norioike/rino-Original-Robot/circuit_board/BOM_20200608.xlsx

Sheet: BOM
 | Total assembly board | 3 | pcs
# | Parts | QTY/module | Toal QTY | Manufacturer Part number | Value | Description | Package (inch) | SMD/THD | Accept to replace | Order assembling | Purchase site | Purchase link 1 | Purchase Link 2 | Note
1 | C1,C2 | 2 | 6 | CL10C300JB8NNNC | CAP CER 30PF 50V C0G/NP0 0603 | Capacitor | C0603 | SMD | YES | YES | LCSC | https://lcsc.com/product-detail/Multilayer-Ceramic-Capacitors-MLCC-SMD-SMT_SAMSUNG_CL10C300JB8NNNC_30pF-300-5-50V_C22397.html | https://www.digikey.jp/product-detail/ja/samsung-electro-mechanics/CL10C300JB8NNNC/1276-1021-1-ND/3889107
2 | C3,C7 | 2 | 6 | CL10A105KP8NNNC | CAP CER 1UF 10V X5R 0603 | Capacitor | C0603 | SMD | YES | YES | LCSC | https://lcsc.com/product-detail/Multilayer-Ceramic-Capacitors-MLCC-SMD-SMT_SAMSUNG_CL10A105KP8NNNC_1uF-105-10-10V_C26413.html | https://www.digikey.jp/product-detail/ja/samsung-electro-mechanics/CL10A105KP8NNNC/1276-1182-1-ND/3889268
3 | C4,C5,C9,C10,C12,C13,C15,C16,C17 | 9 | 27 | CC0603ZRY5V8BB104 | CAP CER 0.1UF 25V Y5V 0603 | Capacitor | C0603 | SMD | YES | YES | LCSC | https://lcsc.com/product-detail/Multilayer-Ceramic-Capacitors-MLCC-SMD-SMT_YAGEO-CC0603ZRY5V8BB104_C389102.html | https://www.digikey.jp/product-detail/ja/yageo/CC0603ZRY5V8BB104/311-1087-1-ND/302997
4 | C6,C8 | 2 | 6 | CC0603JRNPO9BN300 | CAP CER 22PF 50V C0G/NPO 0603 | Capacitor | C0603 | SMD | YES | YES | LCSC | https://lcsc.com/product-detail/Multilayer-Ceramic-Capacitors-MLCC-SMD-SMT_22pF-220-5-50V_C105620.html | https://www.digikey.jp/product-detail/ja/yageo/CC0603JRNPO9BN220/311-1062-1-ND/302972
5 | C11 | 1 | 3 | CL10A475KP8NNNC | CAP CER 4.7UF 10V X5R 0603 | Capacitor | C0603 | SMD | YES | YES | LCSC | https://lcsc.com/product-detail/Multilayer-Ceramic-Capacitors-MLCC-SMD-SMT_SAMSUNG_CL10A475KP8NNNC_4-7uF-475-10-10V_C1705.htmll | https://www.digikey.jp/product-detail/ja/samsung-electro-mechanics/CL10A475KP8NNNC/1276-1044-1-ND/3889130
6 | C14 | 1 | 3 | GRM21BR61A226ME51L | CAP CER 22UF 10V X5R 0805 | Capacitor | C0805 | SMD | YES | YES | LCSC | https://lcsc.com/product-detail/Multilayer-Ceramic-Capacitors-MLCC-SMD-SMT_muRata_GRM21BR61A226ME51L_22uF-226-20-10V_C77074.html | https://www.digikey.jp/product-detail/ja/murata-electronics/GRM21BR61A226ME51L/490-10511-1-ND/5026441
7 | CN1 | 1 | 3 | B5B-PH-K-S(LF)(SN) | CONN HEADER VERT 5POS 2MM | Connector |  | THD | YES | YES | LCSC | https://lcsc.com/product-detail/Wire-To-Board-Wire-To-Wire-Connector_JST-Sales-America_B5B-PH-K-S-LF-SN_JST-Sales-America-B5B-PH-K-S-LF-SN_C157993.html | https://www.digikey.jp/products/ja?keywords=B5B-PH-K-S(LF)(SN)
8 | CN2,CN3 | 2 | 6 | S3B-PH-SM4-TB(LF)(SN) | CONN HEADER SMD R/A 3POS 2MM | Connector |  | SMD | YES | YES | LCSC | https://lcsc.com/product-detail/Wire-To-Board-Wire-To-Wire-Connector_JST-Sales-America_S3B-PH-SM4-TB-LF-SN_JST-Sales-America-S3B-PH-SM4-TB-LF-SN_C265101.html | https://www.digikey.jp/product-detail/ja/jst-sales-america-inc/S3B-PH-SM4-TB-LF-SN/455-1750-1-ND/926847
9 | D1,D2 | 2 | 6 | MBR0520LT3G | DIODE SCHOTTKY 20V 500MA SOD123 | Diode | SOD-123 | SMD | YES | YES | LCSC | https://lcsc.com/product-detail/New-Quadratic-Unclassified-Data_Shikues-MBR0520_C475717.html | https://www.digikey.jp/product-detail/ja/on-semiconductor/MBR0520LT3G/MBR0520LT3GOSCT-ND/2705022
10 | EN,IO0 | 2 | 6 | KMR621NG LFS | SWITCH TACTILE SPST-NO 50MA 32V | tacktile switch |  | SMD | YES | YES | digikey | https://www.digikey.jp/product-detail/ja/c-k/KMR621NG-LFS/CKN10684CT-ND/6035356
11 | J1 | 1 | 3 | MC-318 | USB - Type C Female 24 SMD USB Connectors RoHS | USB type C |  | SMD | YES | YES | LCSC | https://www.digikey.jp/product-detail/ja/w%C3%BCrth-elektronik/632722110112/732-13724-1-ND/10056482 | https://lcsc.com/product-detail/USB-Connectors_SOFNG-MC-318_C183608.html
12 | J2 | 1 | 3 | M20-8890345 | CONN HEADER SMD R/A 3POS 2.54MM | pin header |  | SMD | YES | YES | digikey | https://www.digikey.jp/product-detail/ja/harwin-inc/M20-8890345/952-3232-ND/6565716
13 | LED1 | 1 | 3 | NCD0603G1 | Green 515~530nm 0603 Light Emitting Diodes (LED) RoHS | chip led | LED0603 | SMD | YES | YES | LCSC | https://lcsc.com/product-detail/Light-Emitting-Diodes-LED_Red-LED-SMDLED-80-100mcd_C84263.html
14 | LED2 | 1 | 3 | NCD0603R1 | Red 615~630nm 0603 Light Emitting Diodes (LED) RoHS | chip led | LED0603 | SMD | YES | YES | LCSC | https://lcsc.com/product-detail/Light-Emitting-Diodes-LED_Emerald-SMDLED-330-400mcd_C84267.html
15 | LED3 | 1 | 3 | NCD0603B1 | Blue 463~475nm 0603 Light Emitting Diodes (LED) RoHS | chip led | LED0603 | SMD | YES | YES | LCSC | https://lcsc.com/product-detail/Light-Emitting-Diodes-LED_Blue-light-SMDLED-80-100mcdatIF-10mA_C84266.html
16 | Q1 | 1 | 3 | BSS138 | N Channel 50V 220mA 1.6V @ 1mA 3.5Ω @ 220mA,10V 225mW SOT-23 MOSFET RoHS | Nch FET | SOT23 | SMD | YES | YES | LCSC | https://lcsc.com/product-detail/MOSFET_Slkor-SLKORMICRO-Elec-BSS138_C426569.html
17 | R1 | 1 | 3 | 0603WAJ0121T5E | 120 ±5% 1/10W ±100ppm/°C 0603 Chip Resistor - Surface Mount RoHS | Resistor | R0603 | SMD | YES | YES | LCSC | https://lcsc.com/product-detail/Chip-Resistor-Surface-Mount_UNI-ROYAL-Uniroyal-Elec-0603WAJ0121T5E_C25205.html
18 | R2,R5,R7 | 3 | 9 | RS-03K102JT | 1K ±5% 1/10W ±100ppm/°C 0603 Chip Resistor - Surface Mount RoHS | Resistor | R0603 | SMD | YES | YES | LCSC | https://lcsc.com/product-detail/Chip-Resistor-Surface-Mount_FH-Guangdong-Fenghua-Advanced-Tech-RS-03K102JT_C73797.html
19 | R3,R4,R6,R8,R9,R10,R13 | 7 | 21 | LE03WAJ0103T5E | 10K ±5% 1/10W 0603 LED Strip Resistors RoHS | Resistor | R0603 | SMD | YES | YES | LCSC | https://lcsc.com/product-detail/LED-Strip-Resistors_UNI-ROYAL-Uniroyal-Elec-LE03WAJ0103T5E_C81087.html
20 | R11,R12 | 2 | 6 | WR06X472JTL | 4.7K ±5% 1/10W ±100ppm/°C 0603 Chip Resistor - Surface Mount RoHS | Resistor | R0603 | SMD | YES | YES | LCSC | https://lcsc.com/product-detail/Chip-Resistor-Surface-Mount_Walsin-Tech-Corp-WR06X472JTL_C163915.html
21 | T1,T2 | 2 | 6 | SS8050G-Y1 | NPN 1.5A 25V 300mW SOT-23 Transistors (NPN/PNP) RoHS | Transistor | SOT23 | SMD | YES | YES | LCSC | https://lcsc.com/product-detail/New-Arrivals_Galaxy-SS8050G-Y1_C380930.html
22 | Y1 | 1 | 3 | X201616MOD4SI | 16MHz ±20ppm 12pF SMD-2016_4P SMD Crystal Resonators RoHS | crystal | SMD-2016_4P | SMD | YES | YES | LCSC | https://lcsc.com/product-detail/SMD-Crystal-Resonators_Yangxing-Tech-X201616MOD4SI_C108155.html
23 | U1 | 1 | 3 | MCP3425A0T-E/CH | 16 15 1 Differential SOT-23-6 Analog To Digital Converters (ADCs) RoHS | ADC | SOT-23-6 | SMD | NO | YES | LCSC | https://lcsc.com/product-detail/Analog-To-Digital-Converters-ADCs_MICROCHIP_MCP3425A0T-E-CH_MCP3425A0T-E-CH_C66823.html
24 | U2 | 1 | 3 | TJA1050T/CM,118 | Transceiver CAN 1/1 SOIC-8_150mil CAN ICs RoHS | TJA1050 | SOIC-8_150mil | SMD | NO | YES | LCSC | https://lcsc.com/product-detail/CAN-ICs_NXP-Semicon_TJA1050T-CM-118_NXP-Semicon-TJA1050T-CM-118_C6952.html
25 | U3 | 1 | 3 | MIC5504-3.3YM5-TR | Fixed 5.5V 3.3V 300mA SOT-23-5 Low Dropout Regulators(LDO) RoHS | LDO | SOT-23-5 | SMD | NO | YES | LCSC | https://lcsc.com/product-detail/_MICROCHIP_MIC5504-3-3YM5-TR_MIC5504-3-3YM5-TR_C88419.html
26 | U4 | 1 | 3 | MCP2515T-I/ST | Controller CAN TSSOP-20 CAN ICs RoHS | CAN Controller | TSSOP-20 | SMD | NO | YES | LCSC | https://lcsc.com/product-detail/CAN-ICs_Microchip-Tech_MCP2515T-I-ST_Microchip-Tech-MCP2515T-I-ST_C185941.html
27 | U5 | 1 | 3 | FT231XS-R | SSOP-20 USB ICs RoHS | USB IC | SSOP-20 | SMD | NO | YES | LCSC | https://lcsc.com/product-detail/USB-ICs_FTDI-Future-Designs_FT231XS-R_FTDI-Future-Designs-FT231XS-R_C132160.html
28 | U6 | 1 | 3 | ESP32-WROOM-32D(16MB) | Module WIFI Modules RoHS | MCU |  | SMD | NO | YES | LCSC | https://lcsc.com/product-detail/WIFI-Modules_Espressif-Systems-ESP32-WROOM-32D-16MB_C529578.html |  | Need TELEC MARK
29 | U7,U8,U9,U10,U11,U12,U13,U14,U15,U16, | 10 | 30 | WS2812B-2020 | full clolor LED with IC | full color LED | 2022 Package | SMD | NO | YES | aliexpress | https://ja.aliexpress.com/item/32876864437.html | http://www.world-semi.com/solution/list-4-1.html
30 | U17,U18,U19,U20,U21,U22,U23,U24,U25,U26, | 10 | 30 | WS2812B-2020 | full clolor LED with IC | full color LED | 2022 Package | SMD | NO | YES | aliexpress | https://ja.aliexpress.com/item/32876864437.html
31 | U27,U28,U29,U30,U31,U32,U33,U34,U35,U36, | 10 | 30 | WS2812B-2020 | full clolor LED with IC | full color LED | 2022 Package | SMD | NO | YES | aliexpress | https://ja.aliexpress.com/item/32876864437.html
32 | U37,U38,U39,U40,U41,U42,U43,U44,U45,U46, | 10 | 30 | WS2812B-2020 | full clolor LED with IC | full color LED | 2022 Package | SMD | NO | YES | aliexpress | https://ja.aliexpress.com/item/32876864437.html
33 | U47,U48,U49,U50,U51,U52,U53,U54,U55,U56, | 10 | 30 | WS2812B-2020 | full clolor LED with IC | full color LED | 2022 Package | SMD | NO | YES | aliexpress | https://ja.aliexpress.com/item/32876864437.html
34 | U57,U58,U59,U60,U61,U62,U63,U64,U65,U66, | 10 | 30 | WS2812B-2020 | full clolor LED with IC | full color LED | 2022 Package | SMD | NO | YES | aliexpress | https://ja.aliexpress.com/item/32876864437.html
35 | U67,U68,U69,U70,U71,U72,U73,U74,U75,U76, | 10 | 30 | WS2812B-2020 | full clolor LED with IC | full color LED | 2022 Package | SMD | NO | YES | aliexpress | https://ja.aliexpress.com/item/32876864437.html
36 | U77,U78,U79,U80,U81,U82,U83,U84,U85,U86, | 10 | 30 | WS2812B-2020 | full clolor LED with IC | full color LED | 2022 Package | SMD | NO | YES | aliexpress | https://ja.aliexpress.com/item/32876864437.html
37 | U87,U88,U89,U90,U91,U92,U93,U94,U95,U96, | 10 | 30 | WS2812B-2020 | full clolor LED with IC | full color LED | 2022 Package | SMD | NO | YES | aliexpress | https://ja.aliexpress.com/item/32876864437.html
38 | U97,U98,U99,U100,U101,U102,U103,U104,U105,U106, | 10 | 30 | WS2812B-2020 | full clolor LED with IC | full color LED | 2022 Package | SMD | NO | YES | aliexpress | https://ja.aliexpress.com/item/32876864437.html
39 | U107,U108,U109,U110,U111,U112,U113,U114,U115,U116, | 10 | 30 | WS2812B-2020 | full clolor LED with IC | full color LED | 2022 Package | SMD | NO | YES | aliexpress | https://ja.aliexpress.com/item/32876864437.html
40 | U117,U118,U119,U120,U121,U122,U123,U124,U125,U126, | 10 | 30 | WS2812B-2020 | full clolor LED with IC | full color LED | 2022 Package | SMD | NO | YES | aliexpress | https://ja.aliexpress.com/item/32876864437.html
41 | U127,U128,U129,U130,U131,U132,U133,U134,U135,U136, | 10 | 30 | WS2812B-2020 | full clolor LED with IC | full color LED | 2022 Package | SMD | NO | YES | aliexpress | https://ja.aliexpress.com/item/32876864437.html
42 | U137,U138,U139,U140,U141,U142,U143,U144,U145,U146, | 10 | 30 | WS2812B-2020 | full clolor LED with IC | full color LED | 2022 Package | SMD | NO | YES | aliexpress | https://ja.aliexpress.com/item/32876864437.html
43 | U147,U148,U149,U150,U151,U152,U153,U154,U155,U156, | 10 | 30 | WS2812B-2020 | full clolor LED with IC | full color LED | 2022 Package | SMD | NO | YES | aliexpress | https://ja.aliexpress.com/item/32876864437.html
44 | U157,U158,U159,U160,U161,U162,U163,U164,U165,U166, | 10 | 30 | WS2812B-2020 | full clolor LED with IC | full color LED | 2022 Package | SMD | NO | YES | aliexpress | https://ja.aliexpress.com/item/32876864437.html
45 | U167,U168,U169,U170,U171,U172,U173,U174,U175,U176, | 10 | 30 | WS2812B-2020 | full clolor LED with IC | full color LED | 2022 Package | SMD | NO | YES | aliexpress | https://ja.aliexpress.com/item/32876864437.html
46 | U177,U178,U179,U180,U181,U182,U183,U184,U185,U186, | 10 | 30 | WS2812B-2020 | full clolor LED with IC | full color LED | 2022 Package | SMD | NO | YES | aliexpress | https://ja.aliexpress.com/item/32876864437.html
47 | U187,U188,U189,U190,U191,U192,U193,U194,U195,U196, | 10 | 30 | WS2812B-2020 | full clolor LED with IC | full color LED | 2022 Package | SMD | NO | YES | aliexpress | https://ja.aliexpress.com/item/32876864437.html
48 | U197,U198,U199,U200,U201,U202,U203,U204,U205,U206, | 10 | 30 | WS2812B-2020 | full clolor LED with IC | full color LED | 2022 Package | SMD | NO | YES | aliexpress | https://ja.aliexpress.com/item/32876864437.html
49 | U207,U208,U209,U210,U211,U212,U213,U214,U215,U216, | 10 | 30 | WS2812B-2020 | full clolor LED with IC | full color LED | 2022 Package | SMD | NO | YES | aliexpress | https://ja.aliexpress.com/item/32876864437.html
50 | U217,U218,U219,U220,U221,U222,U223,U224,U225,U226, | 10 | 30 | WS2812B-2020 | full clolor LED with IC | full color LED | 2022 Package | SMD | NO | YES | aliexpress | https://ja.aliexpress.com/item/32876864437.html
51 | U227,U228,U229,U230,U231,U232,U233,U234,U235,U236, | 10 | 30 | WS2812B-2020 | full clolor LED with IC | full color LED | 2022 Package | SMD | NO | YES | aliexpress | https://ja.aliexpress.com/item/32876864437.html
52 | U237,U238,U239,U240,U241,U242,U243,U244,U245,U246, | 10 | 30 | WS2812B-2020 | full clolor LED with IC | full color LED | 2022 Package | SMD | NO | YES | aliexpress | https://ja.aliexpress.com/item/32876864437.html
53 | U247,U248,U249,U250,U251,U252,U253,U254,U255,U256, | 10 | 30 | WS2812B-2020 | full clolor LED with IC | full color LED | 2022 Package | SMD | NO | YES | aliexpress | https://ja.aliexpress.com/item/32876864437.html
54 | U257,U258,U259,U260,U261,U262,U263,U264,U265,U266, | 10 | 30 | WS2812B-2020 | full clolor LED with IC | full color LED | 2022 Package | SMD | NO | YES | aliexpress | https://ja.aliexpress.com/item/32876864437.html
55 | U267,U268,U269,U270,U271,U272,U273,U274,U275,U276, | 10 | 30 | WS2812B-2020 | full clolor LED with IC | full color LED | 2022 Package | SMD | NO | YES | aliexpress | https://ja.aliexpress.com/item/32876864437.html
56 | U277,U278,U279,U280,U281,U282,U283,U284,U285,U286 | 10 | 30 | WS2812B-2020 | full clolor LED with IC | full color LED | 2022 Package | SMD | NO | YES | aliexpress | https://ja.aliexpress.com/item/32876864437.html

Sheet: PCB Spec
PCB specification |  | Shipping address
Layer | 2 | postal code | 259-1132
board Dimensions | 134 x 126 mm | address | 2-19-39,Sakuradai,Isehara city,Kanagawa,Japan
PCB Qty | 7
Surface Finish | HASL free
PCB Color | Matt black
Copper Weight | 1oz
Text Color | White
Defferent Design | 2
PCB thickness | 1.6mm

Sheet: シート1
type C usb connector | https://lcsc.com/product-detail/USB-Connectors_SOFNG-MC-318_C183608.html
クロック | https://lcsc.com/product-detail/SMD-Crystal-Resonators_Yangxing-Tech-X201616MOD4SI_C108155.html
