norioike/rino-Original-Robot/circuit_board/mainBoard_schematic_1page.pdf

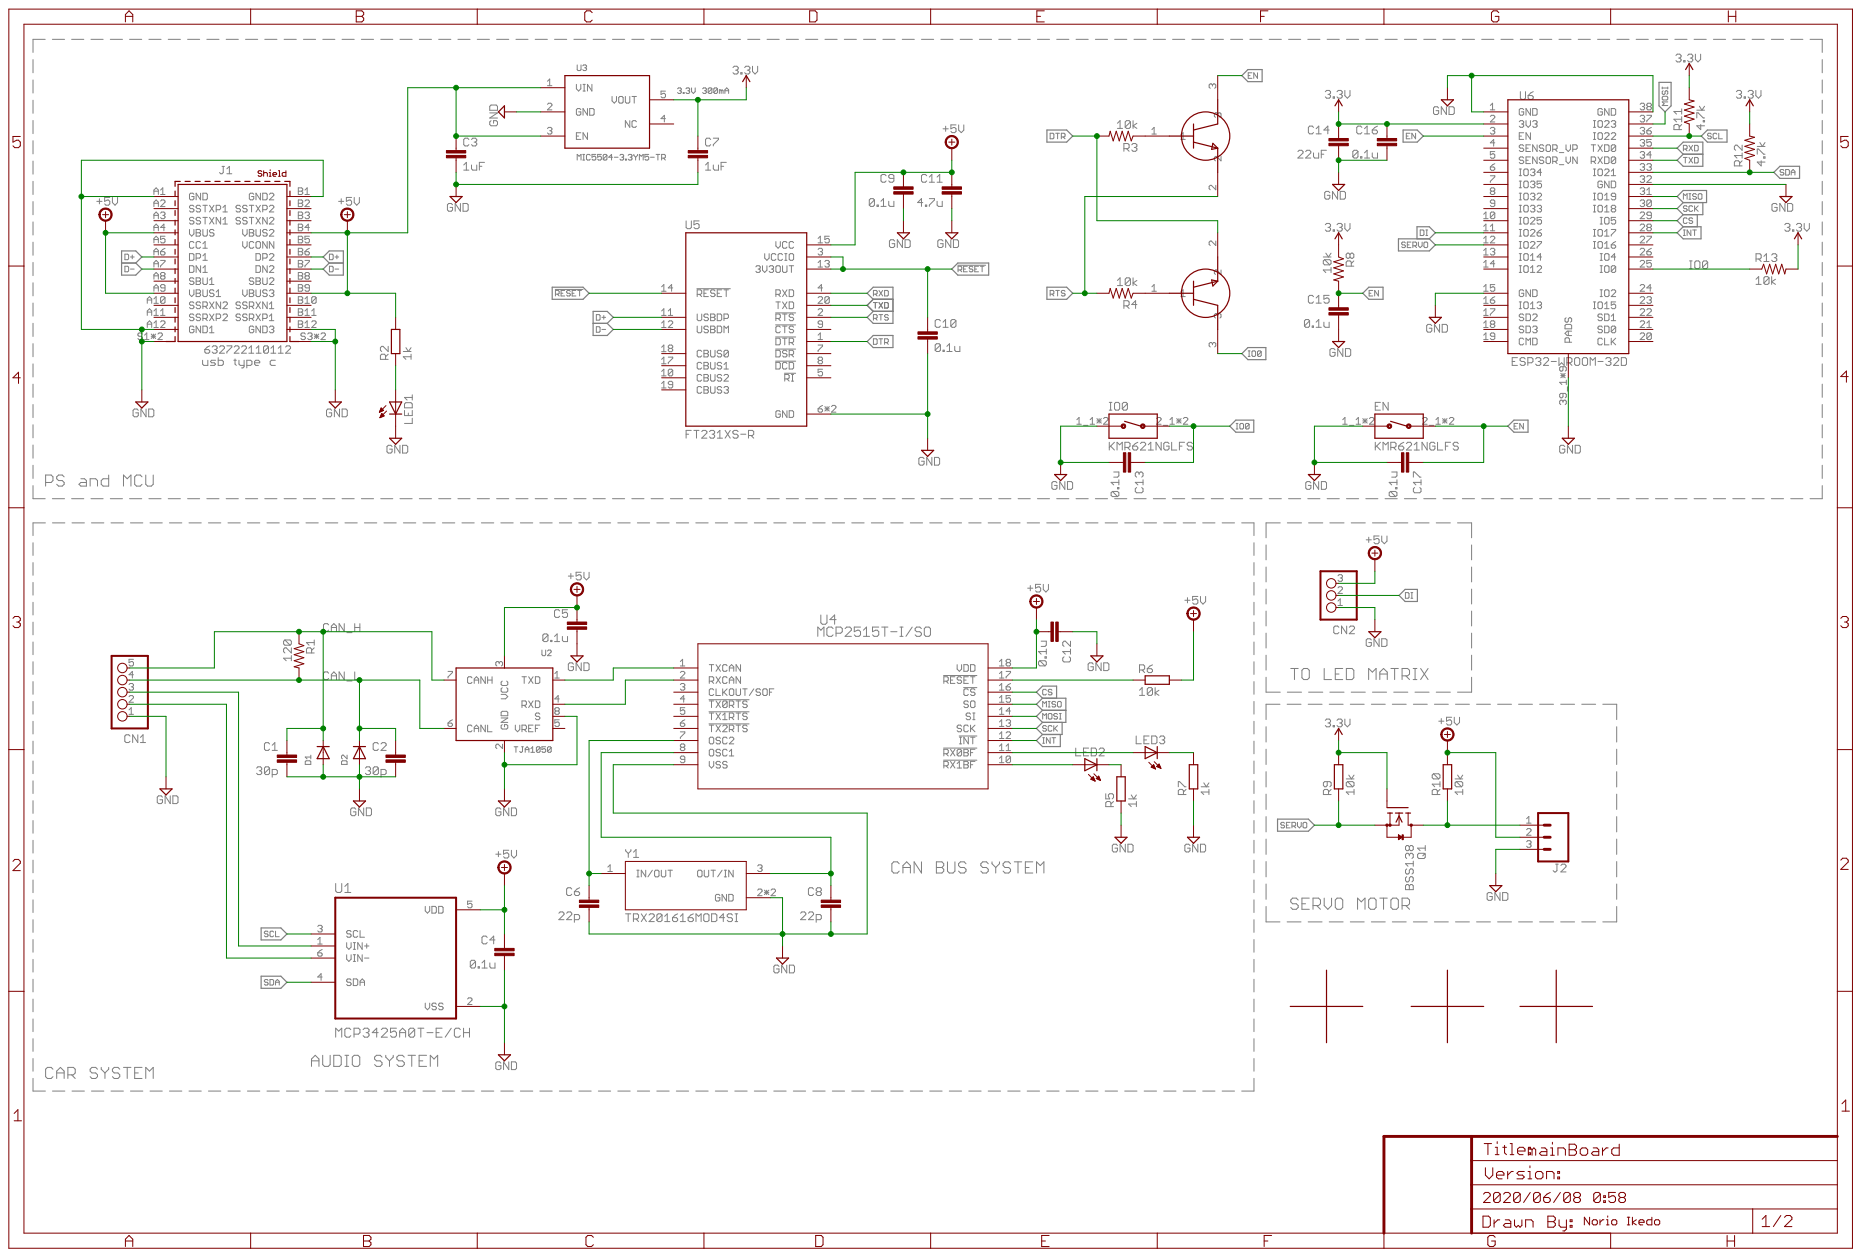
[picture p1: page 1]
