norioike/rino-Original-Robot/circuit_board/mainBoard_schematic_2page.pdf

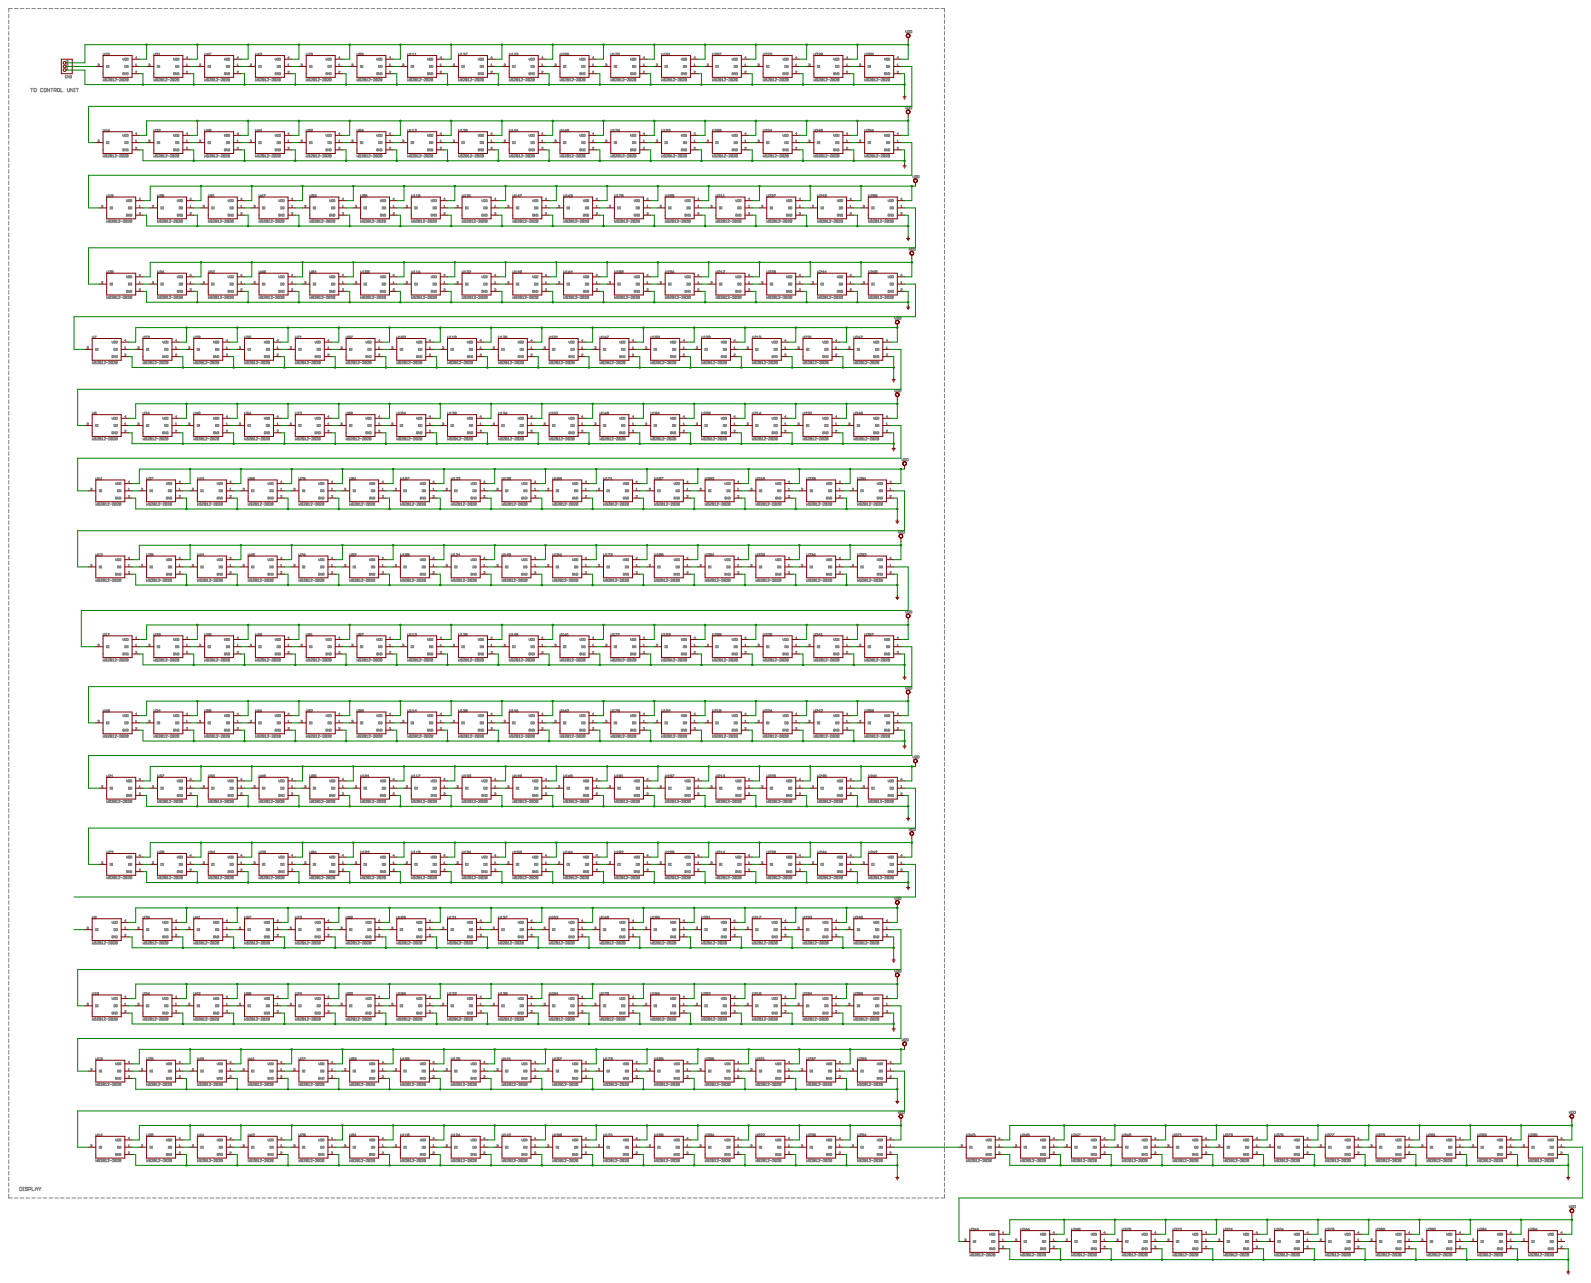
[picture p2: page 1]
