norioike/rino-Original-Robot/circuit_board/mainBoard_brd_data.pdf

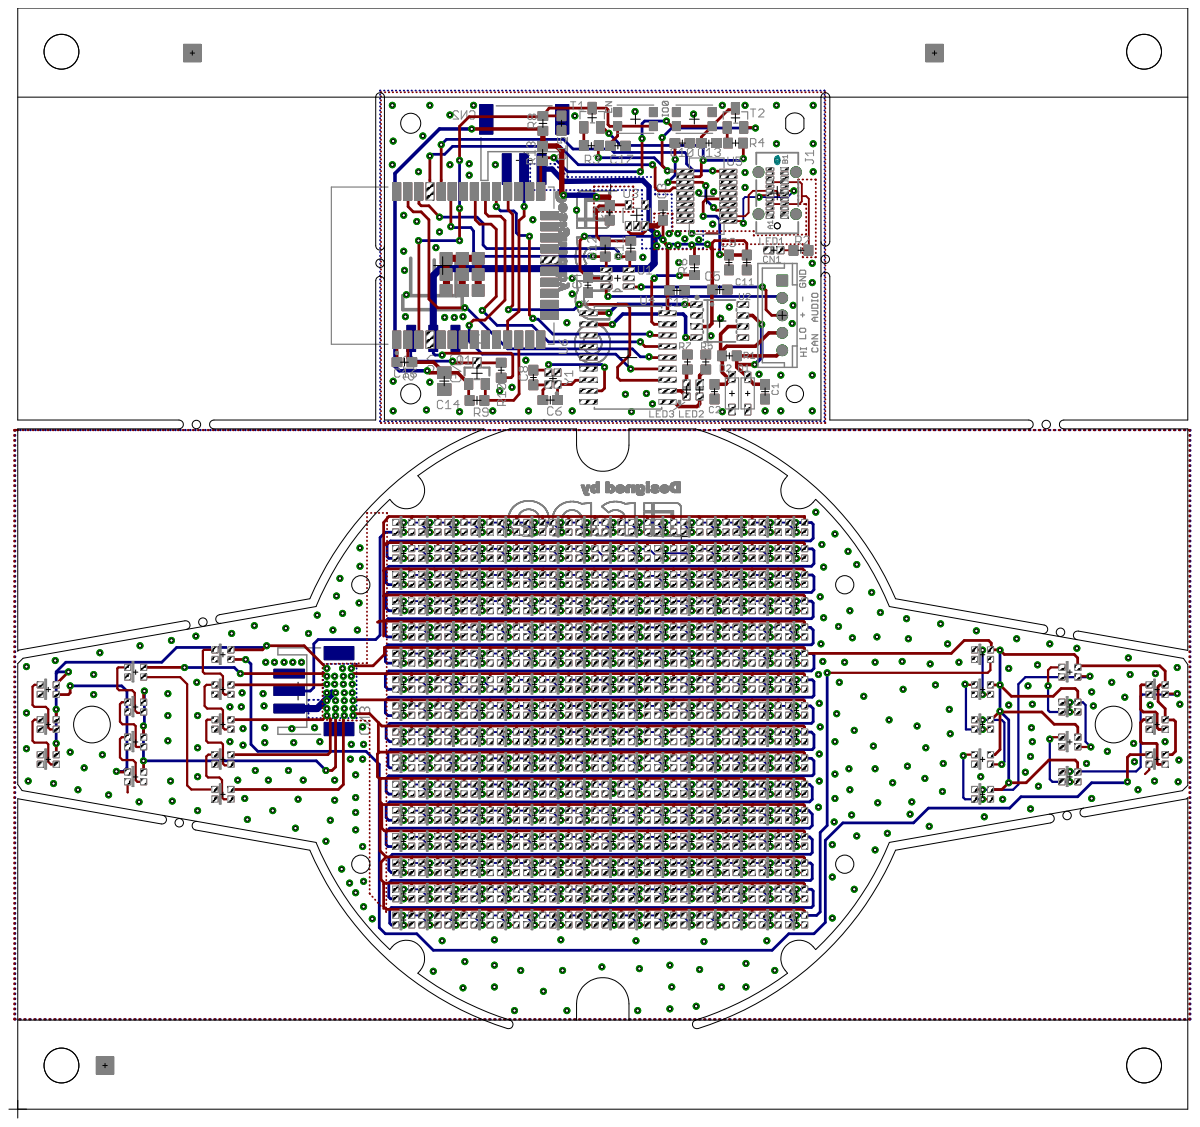
[picture p3: page 1]
