norioike/rino-Original-Robot/arduino software/picture_preset.h

//preset
//アスラーダの目のやつ
uint32_t asrada[] = {
  0x00000000, 0x00000000, 0x00000000, 0x00000000, 0x00000000, 0x00000000, 0x00000000, 0x00000000, 0x00000000, 0x00000000, 0x00000000, 0x00000000, 0x00000000, 0x00000000, 0x00000000, 0x00000000,
  0x00000000, 0x00000000, 0x00000000, 0x00000000, 0x00000000, 0x00000000, 0x00000000, 0x00000000, 0x00000000, 0x00000000, 0x00000000, 0x00000000, 0x00000000, 0x00000000, 0x00000000, 0x00000000,
  0x00000000, 0x00000000, 0x00000000, 0x00FF0010, 0x00FF0010, 0x00FF0010, 0x00000000, 0x00000000, 0x00000000, 0x00000000, 0x00FF0010, 0x00FF0010, 0x00FF0010, 0x00000000, 0x00000000, 0x00000000,
  0x00000000, 0x00000000, 0x00FF0010, 0x00FF0010, 0x00FF0010, 0x00FF0010, 0x00FF0010, 0x00000000, 0x00000000, 0x00FF0010, 0x00FF0010, 0x00FF0010, 0x00FF0010, 0x00FF0010, 0x00000000, 0x00000000,
  0x00000000, 0x00000000, 0x00FF0010, 0x00FF0010, 0x00FF0010, 0x00FF0010, 0x00FF0010, 0x00000000, 0x00000000, 0x00FF0010, 0x00FF0010, 0x00FF0010, 0x00FF0010, 0x00FF0010, 0x00000000, 0x00000000,
  0x00000000, 0x00000000, 0x00FF0010, 0x00FF0010, 0x00FF0010, 0x00FF0010, 0x00FF0010, 0x00000000, 0x00000000, 0x00FF0010, 0x00FF0010, 0x00FF0010, 0x00FF0010, 0x00FF0010, 0x00000000, 0x00000000,
  0x00000000, 0x00000000, 0x00000000, 0x00FF0010, 0x00FF0010, 0x00FF0010, 0x00000000, 0x00000000, 0x00000000, 0x00000000, 0x00FF0010, 0x00FF0010, 0x00FF0010, 0x00000000, 0x00000000, 0x00000000,
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
  0x00000000, 0x00000000, 0x00000000, 0x00000000, 0x00000000, 0x00000000, 0x00000000, 0x00000000, 0x00000000, 0x00000000, 0x00000000, 0x00000000, 0x00000000, 0x00000000, 0x00000000, 0x00000000,
};
